oleg-milantiev/ros2-vedrus/Orange Extension Board/HMC5883L.png

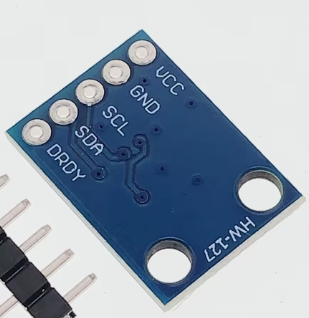
Orange Extension Board/HMC5883L.png
