oleg-milantiev/ros2-vedrus/Orange Extension Board/ads1115.png

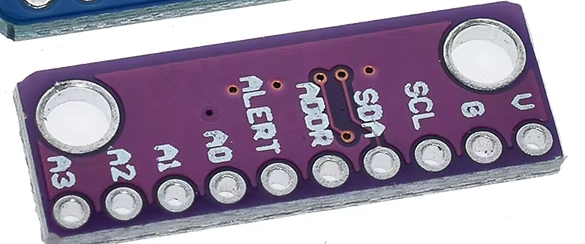
Orange Extension Board/ads1115.png
