oleg-milantiev/ros2-vedrus/README.md

# ros2-vedrus
ROS2 Vedrusohod bot sources
