oleg-milantiev/ros2-vedrus/yolo-world/idea.md

Я создаю DIY робота с элементами исскуственного интеллекта.
Предо мною стоит задача создания датасета с четырёх камер бота.
Я хочу поездить по участку и попросить YOLO-world детектировать для меня ёлку, дом, сарай и другие ориентиры, видимые роботом с разных сторон.
Я буду использовать ограниченный, чётко формализованный список классов, применимый именно для моего участка и объектов на нём.
После составления датасета и его ручной проверки я планирую дотренировать YOLOv8 для быстрого поиска объектов во всех четырёх камерах.

Подскажи, пожулуйста, есть ли смысл в подобной оптимизации?
На сколько подобная дообученная YOLOv8 модель быстрей и лучше справится с широкой YOLO-world при запуске на amd64 и nvidia 3060?

Ваш подход к созданию робота с элементами искусственного интеллекта выглядит продуманным и логичным. Использование YOLO-World для первоначальной разметки данных с последующей дообучкой YOLOv8 — это интересная стратегия, которая сочетает преимущества гибкости и скорости. Давайте разберёмся, имеет ли это смысл и как это может повлиять на производительность на вашем оборудовании (AMD64 CPU и NVIDIA RTX 3060 GPU).

### Имеет ли смысл ваш подход?

Да, ваша стратегия имеет смысл по следующим причинам:

1. **YOLO-World для начальной разметки**:
   - YOLO-World — это модель с открытым словарем (open-vocabulary), которая позволяет детектировать произвольные объекты, описанные текстовыми запросами (например, "ёлка", "дом", "сарай"). Это удобно для автоматизации создания датасета, особенно если вы хотите минимизировать ручную разметку.
   - Она не требует предварительного обучения на ваших классах, что экономит время на старте проекта.
   - Однако YOLO-World оптимизирована для универсальности, а не для скорости или специфичности к ограниченному набору классов, что может снижать её эффективность в вашем случае после разметки.

2. **Дообучка YOLOv8**:
   - После создания и проверки датасета дообученная YOLOv8 будет настроена именно на ваши классы ("ёлка", "дом", "сарай" и т.д.), что улучшит точность и скорость детекции для конкретного сценария.
   - YOLOv8 изначально проектировалась как компактная и быстрая модель для задач реального времени, особенно при использовании GPU (например, NVIDIA 3060). Дообучка на вашем датасете сделает её ещё более эффективной для ваших нужд.
   - Вы сможете выбрать подходящий размер модели (например, YOLOv8n для скорости или YOLOv8m для баланса скорости и точности), что даёт гибкость в оптимизации под оборудование.

3. **Оптимизация под задачу**:
   - Ваш случай предполагает ограниченный и чётко определённый список классов. Это идеальный сценарий для дообученной модели, так как она будет лишена "избыточной универсальности" YOLO-World, которая не нужна для фиксированного набора объектов.
   - Дообученная YOLOv8 сможет лучше обобщать данные с ваших камер, учитывая особенности освещения, углов обзора и текстур на вашем участке.

Таким образом, ваш подход позволяет использовать сильные стороны обеих моделей: YOLO-World для быстрого прототипирования и разметки, а YOLOv8 для финальной оптимизированной работы в реальном времени.

---

### Сравнение производительности: дообученная YOLOv8 vs YOLO-World

Чтобы оценить, насколько дообученная YOLOv8 будет быстрее и лучше YOLO-World на вашем оборудовании (AMD64 CPU и NVIDIA RTX 3060), рассмотрим ключевые аспекты:

#### 1. Скорость (FPS — кадры в секунду)
- **YOLO-World**:
  - YOLO-World построена на основе YOLOv8, но включает дополнительные компоненты (например, интеграцию с CLIP для обработки текстовых запросов), что увеличивает вычислительную нагрузку.
  - На NVIDIA RTX 3060 (12 ГБ VRAM, ~5000 CUDA-ядер) YOLO-World (например, версия на базе YOLOv8s) может выдавать около 30-50 FPS при разрешении 640x640 в зависимости от сложности сцены и количества классов в запросе. Однако это значение может снижаться из-за дополнительных вычислений для open-vocabulary возможностей.
  - На CPU (AMD64) её производительность резко падает (до 1-5 FPS), так как модель не оптимизирована для процессоров без CUDA.

- **Дообученная YOLOv8**:
  - YOLOv8 (например, YOLOv8n или YOLOv8s) изначально быстрее благодаря упрощённой архитектуре, заточенной под фиксированные классы.
  - На RTX 3060 YOLOv8n может достигать 100-150 FPS, а YOLOv8s — около 70-100 FPS при разрешении 640x640 с использованием CUDA и оптимизаций (например, TensorRT).
  - На CPU (AMD64) YOLOv8n выдаёт примерно 10-20 FPS, что всё равно значительно лучше, чем YOLO-World, благодаря меньшему количеству параметров и отсутствию лишних вычислений.

- **Вывод**: Дообученная YOLOv8 будет **в 2-3 раза быстрее** YOLO-World на GPU и заметно быстрее на CPU, особенно если вы выберете компактную версию (например, YOLOv8n).

#### 2. Точность (mAP — mean Average Precision)
- **YOLO-World**:
  - Точность YOLO-World зависит от качества текстовых описаний и предварительного обучения на больших наборах данных (например, COCO, Open Images). Для ваших специфичных объектов ("ёлка с моего участка", "сарай с определённым углом") она может быть ниже из-за недостатка контекста в общем предобучении.
  - mAP может составлять 0.3-0.5 для новых объектов в zero-shot режиме, что приемлемо для разметки, но не идеально для точной работы робота.

- **Дообученная YOLOv8**:
  - После дообучки на вашем датасете YOLOv8 будет учитывать особенности ваших объектов и камер, что поднимет mAP до 0.7-0.9 (в зависимости от качества датасета и объёма данных).
  - Специализация на ограниченном наборе классов устраняет "шум" от лишних объектов, что повышает точность детекции.

- **Вывод**: Дообученная YOLOv8 обеспечит **значительно более высокую точность** (на 20-50% выше по mAP) для ваших задач по сравнению с YOLO-World.

#### 3. Ресурсоёмкость
- **YOLO-World**:
  - Имеет больше параметров из-за интеграции CLIP и сложной обработки текстовых запросов. Это увеличивает потребление памяти (VRAM) и вычислительных ресурсов.
  - На RTX 3060 может занимать 4-6 ГБ VRAM, что ограничивает параллельную обработку с четырёх камер без оптимизации.

- **Дообученная YOLOv8**:
  - YOLOv8n (nano) занимает около 1-2 ГБ VRAM, а YOLOv8s — около 3-4 ГБ, что делает её более подходящей для одновременной работы с несколькими потоками (4 камеры).
  - Меньшее количество параметров снижает нагрузку на CPU/GPU, что важно для DIY-робота с ограниченными ресурсами.

- **Вывод**: Дообученная YOLOv8 **менее ресурсоёмка** и лучше подходит для многоканальной обработки.

#### 4. Реальное время на вашем оборудовании
- Для робота с четырьмя камерами критично обрабатывать видео в реальном времени (хотя бы 15-30 FPS на поток).
- YOLO-World на RTX 3060 может не справиться с четырьмя потоками одновременно на приемлемой скорости без серьёзной оптимизации (например, уменьшения разрешения или batch processing).
- YOLOv8 (дообученная) на RTX 3060 с TensorRT или ONNX-оптимизацией легко обеспечит 30+ FPS на поток при разрешении 640x640, что идеально для вашей задачи.

---

### Итоговые рекомендации
1. **Смысл есть**: Ваш подход с использованием YOLO-World для разметки и дообучки YOLOv8 для финальной модели — это разумная комбинация гибкости и производительности.
2. **Преимущества дообученной YOLOv8**:
   - **Скорость**: в 2-3 раза выше (70-150 FPS vs 30-50 FPS на GPU).
   - **Точность**: mAP выше на 20-50% для ваших классов.
   - **Эффективность**: меньшая нагрузка на ресурсы, что критично для работы с 4 камерами.
3. **Выбор версии YOLOv8**:
   - Для максимальной скорости используйте **YOLOv8n** (nano).
   - Для баланса скорости и точности — **YOLOv8s** (small).
   - Настройте размер входного изображения (например, 320x320 вместо 640x640), если нужна ещё большая скорость.
4. **Оптимизация на NVIDIA 3060**:
   - Используйте **TensorRT** для ускорения инференса (может увеличить FPS на 30-50%).
   - Настройте параллельную обработку потоков с камер (например, с помощью multiprocessing или CUDA Streams).

Ваш план оптимизации не только оправдан, но и позволит создать быстрого и точного робота, идеально подходящего для вашего участка. Удачи в проекте! Если будут вопросы по реализации, обращайтесь.
