oleg-milantiev/ros2-vedrus/Orange Extension Board/HC-SR04.jpg

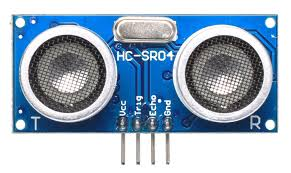
Orange Extension Board/HC-SR04.jpg
