oleg-milantiev/ros2-vedrus/rosgraph.png

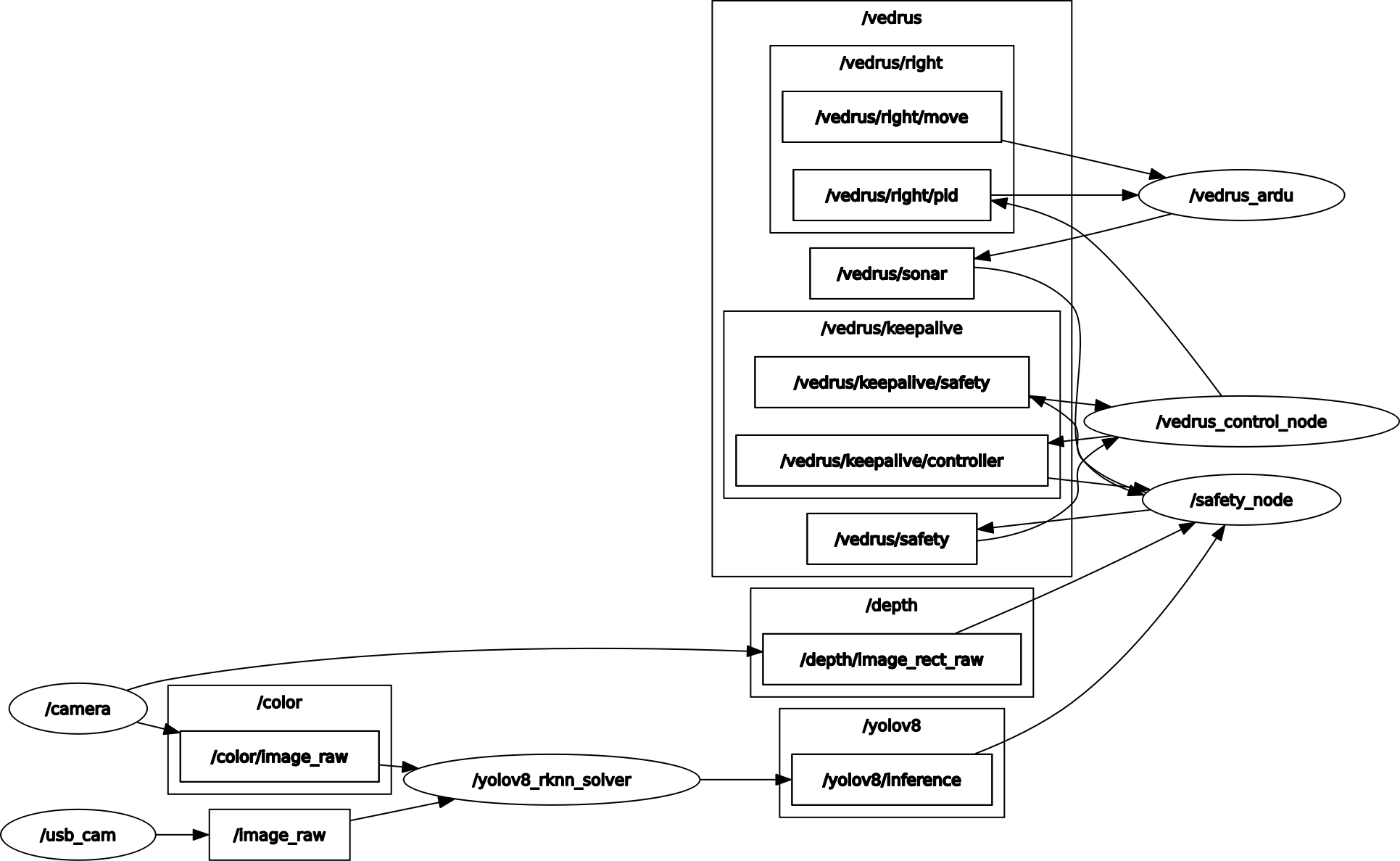
rosgraph.png
