oleg-milantiev/ros2-vedrus/(list of files, cad)

Other CAD files:
Cameras Board.3dm
