oleg-milantiev/ros2-vedrus/Orange Extension Board/Orange Extension Board/Orange Extension Board.kicad_pcb

## KiCad design Orange Extension Board/Orange Extension Board/Orange Extension Board.kicad_pcb (2025-02-04)

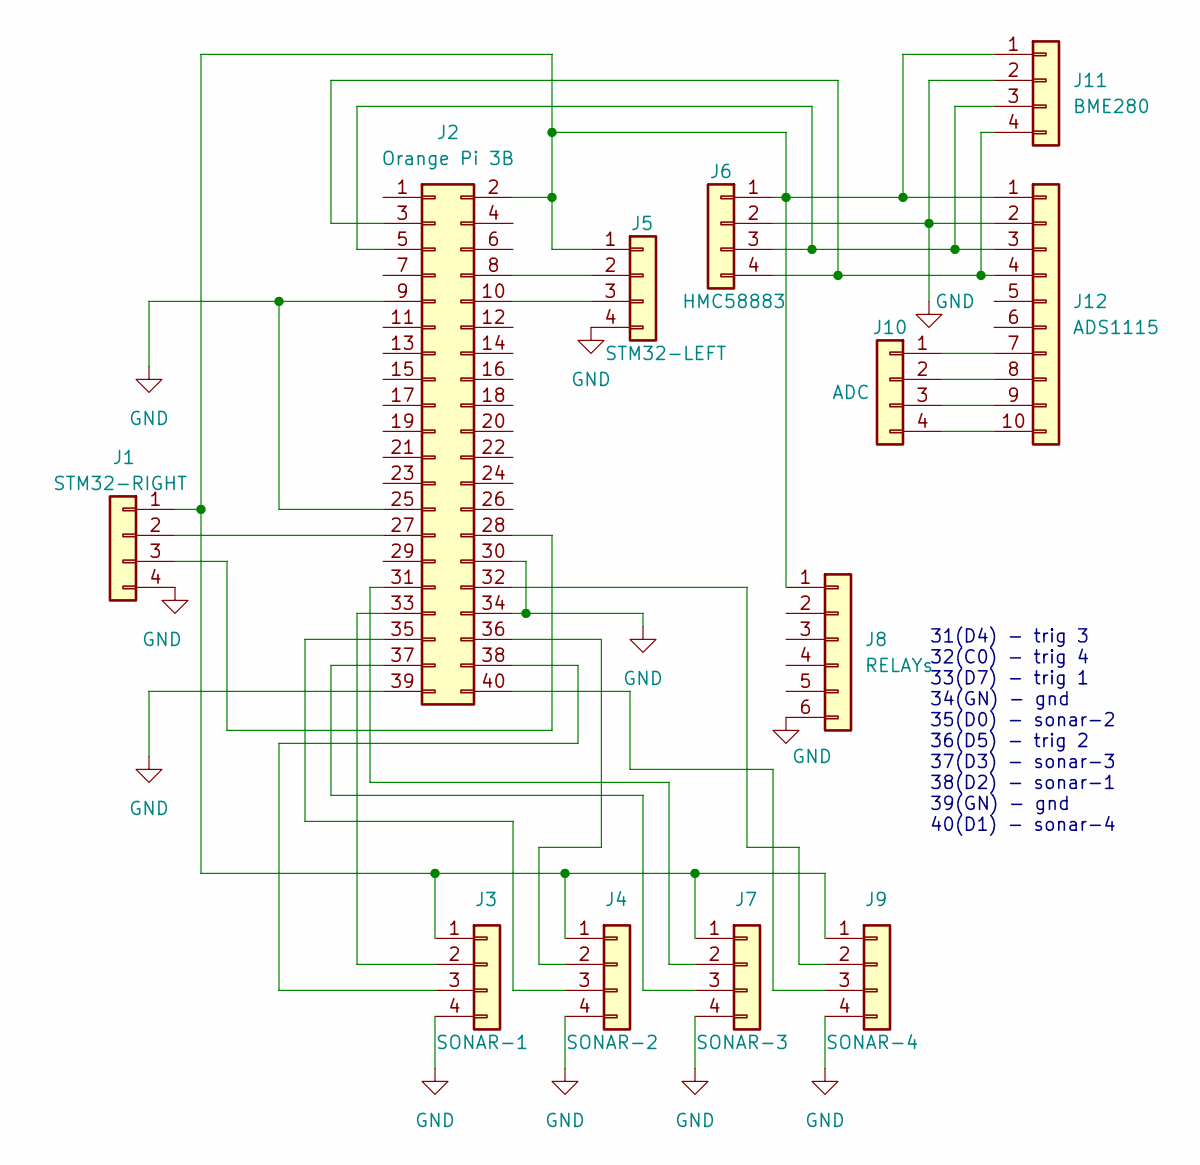
[picture p5: schematic Orange Extension Board.kicad_sch]

Parts:
J1: STM32-RIGHT; PinHeader_1x04_P2.54mm_Vertical
J2: Orange Pi 3B; PinHeader_2x20_P2.54mm_Vertical
J3: SONAR-1; PinHeader_1x04_P2.54mm_Vertical
J4: SONAR-2; PinHeader_1x04_P2.54mm_Vertical
J5: STM32-LEFT; PinHeader_1x04_P2.54mm_Vertical
J6: HMC58883; PinHeader_1x04_P2.54mm_Vertical
J7: SONAR-3; PinHeader_1x04_P2.54mm_Vertical
J8: RELAYs; PinHeader_1x06_P2.54mm_Vertical
J9: SONAR-4; PinHeader_1x04_P2.54mm_Vertical
J10: ADC; PinHeader_1x04_P2.54mm_Vertical
J11: BME280; PinHeader_1x04_P2.54mm_Vertical
J12: ADS1115; PinHeader_1x10_P2.54mm_Vertical

Connections:
GND: J1.4, J2.9, J2.25, J2.30, J2.34, J2.39, J3.4, J4.4, J5.4, J6.2, J7.4, J8.6, J9.4, J11.2, J12.2
unnamed: J1.1, J2.2, J3.1, J4.1, J5.1, J6.1, J7.1, J8.1, J9.1, J11.1, J12.1
unnamed: J1.2, J2.27
unnamed: J1.3, J2.28
unnamed: J2.3, J6.4, J11.4, J12.4
unnamed: J2.5, J6.3, J11.3, J12.3
unnamed: J2.8, J5.2
unnamed: J2.10, J5.3
unnamed: J2.32, J9.2
unnamed: J2.33, J3.2
unnamed: J2.40, J9.3
unnamed: J2.38, J3.3
unnamed: J2.36, J4.2
unnamed: J2.35, J4.3
unnamed: J2.31, J7.2
unnamed: J2.37, J7.3
unnamed: J10.1, J12.7
unnamed: J10.2, J12.8
unnamed: J10.3, J12.9
unnamed: J10.4, J12.10

Notes on the sheet:
31(D4) - trig 3 32(C0) - trig 4 33(D7) - trig 1 34(GN) - gnd 35(D0) - sonar-2 36(D5) - trig 2 37(D3) - sonar-3 38(D2) - sonar-1 39(GN) - gnd 40(D1) - sonar-4

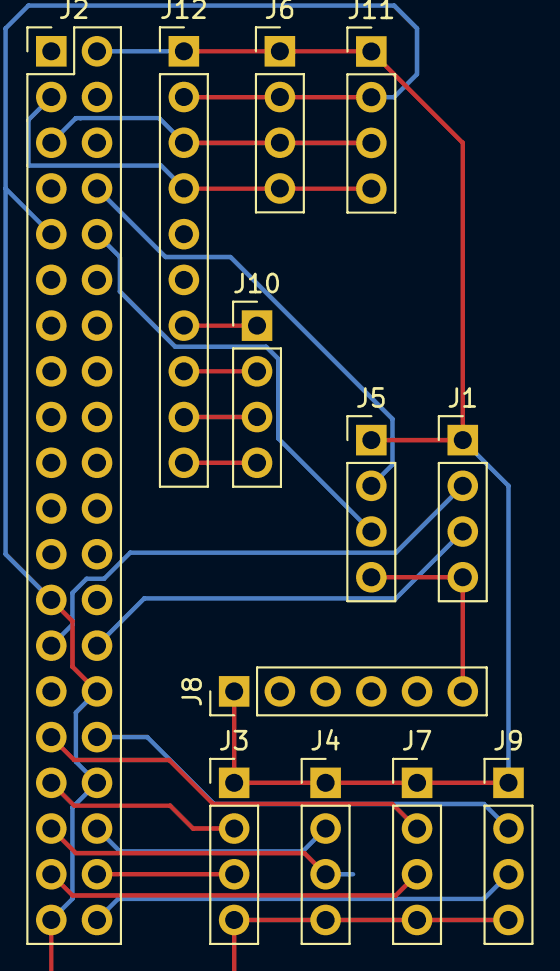
[picture p6: board Orange Extension Board.kicad_pcb from above]

Board: 2 copper layers, 12 parts (0 on the bottom side), 20 nets.
