oleg-milantiev/ros2-vedrus/BluePill/KiCAD/BluePill/BluePill.kicad_pcb

## KiCad design BluePill/KiCAD/BluePill/BluePill.kicad_pcb (2024-12-22)

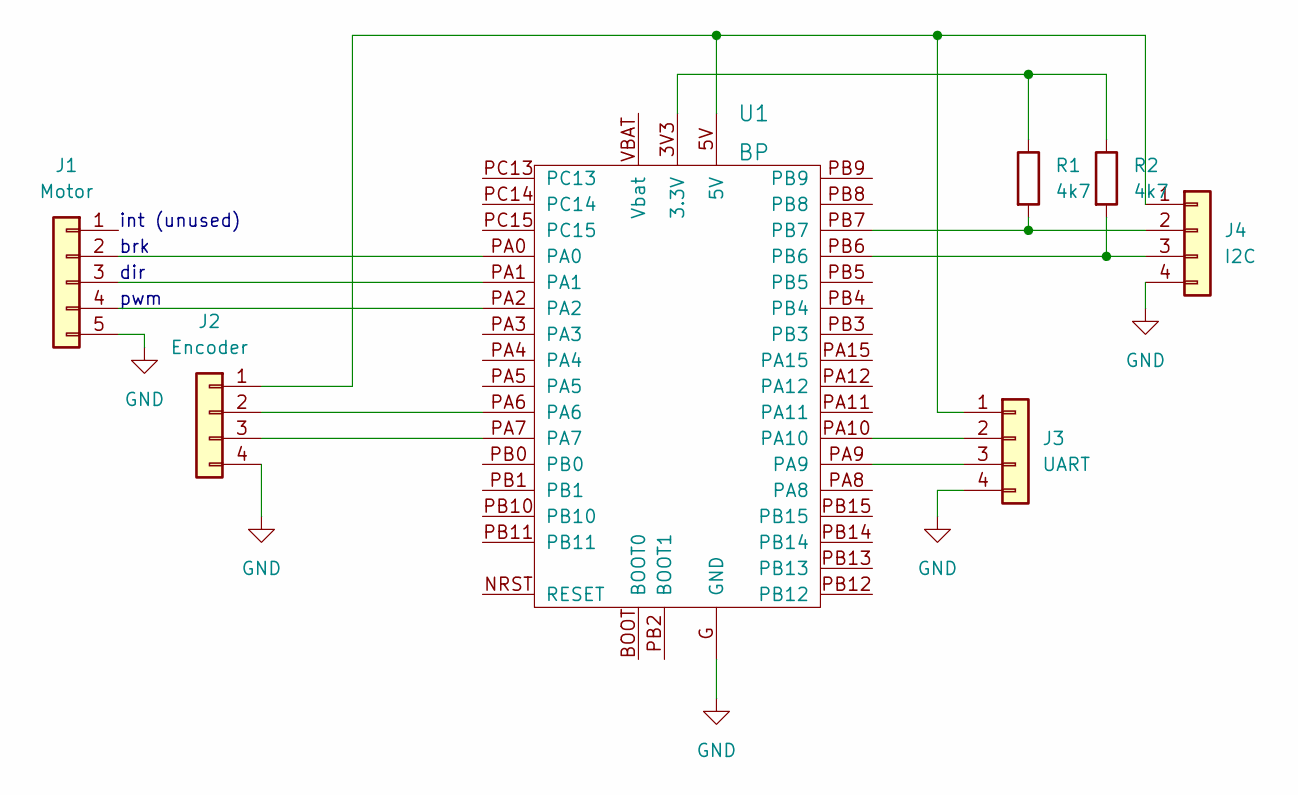
[picture p7: schematic BluePill.kicad_sch]

Parts:
J1: Motor; PinHeader_1x05_P2.54mm_Vertical
J2: Encoder; PinHeader_1x04_P2.54mm_Vertical
J3: UART; PinHeader_1x04_P2.54mm_Vertical
J4: I2C; PinHeader_1x04_P2.54mm_Vertical
R1, R2: 4k7; R_Axial_DIN0204_L3.6mm_D1.6mm_P2.54mm_Vertical
U1: BP; blue_pill

Connections:
GND: J1.5, J2.4, J3.4, J4.4, U1.G (GND)
unnamed: J1.2, U1.PA0
unnamed: J1.3, U1.PA1
unnamed: J1.4, U1.PA2
unnamed: J2.1, J3.1, J4.1, U1.5V
unnamed: J2.2, U1.PA6
unnamed: J2.3, U1.PA7
unnamed: J3.2, U1.PA10
unnamed: J3.3, U1.PA9
unnamed: J4.2, R1.2, U1.PB7
unnamed: J4.3, R2.2, U1.PB6
unnamed: R1.1, R2.1, U1.3V3 (3.3V)

Notes on the sheet:
int (unused)
pwm
dir
brk

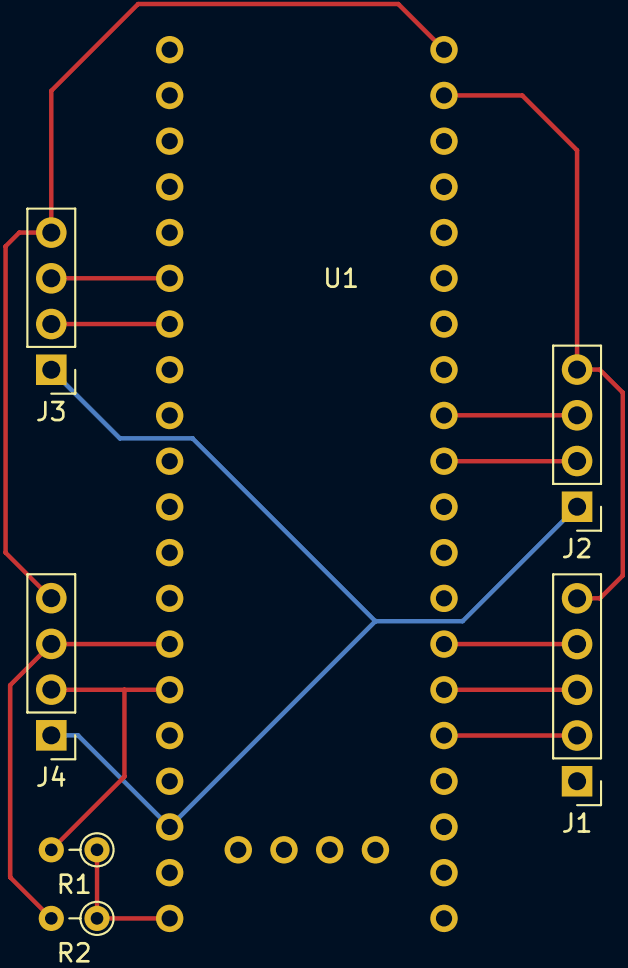
[picture p8: board BluePill.kicad_pcb from above]

Board: 2 copper layers, 7 parts (0 on the bottom side), 12 nets.
