oleg-milantiev/ros2-vedrus/arduino/motor/kicad/vedro-ardu.kicad_pcb

## KiCad design arduino/motor/kicad/vedro-ardu.kicad_pcb (2024-02-14)

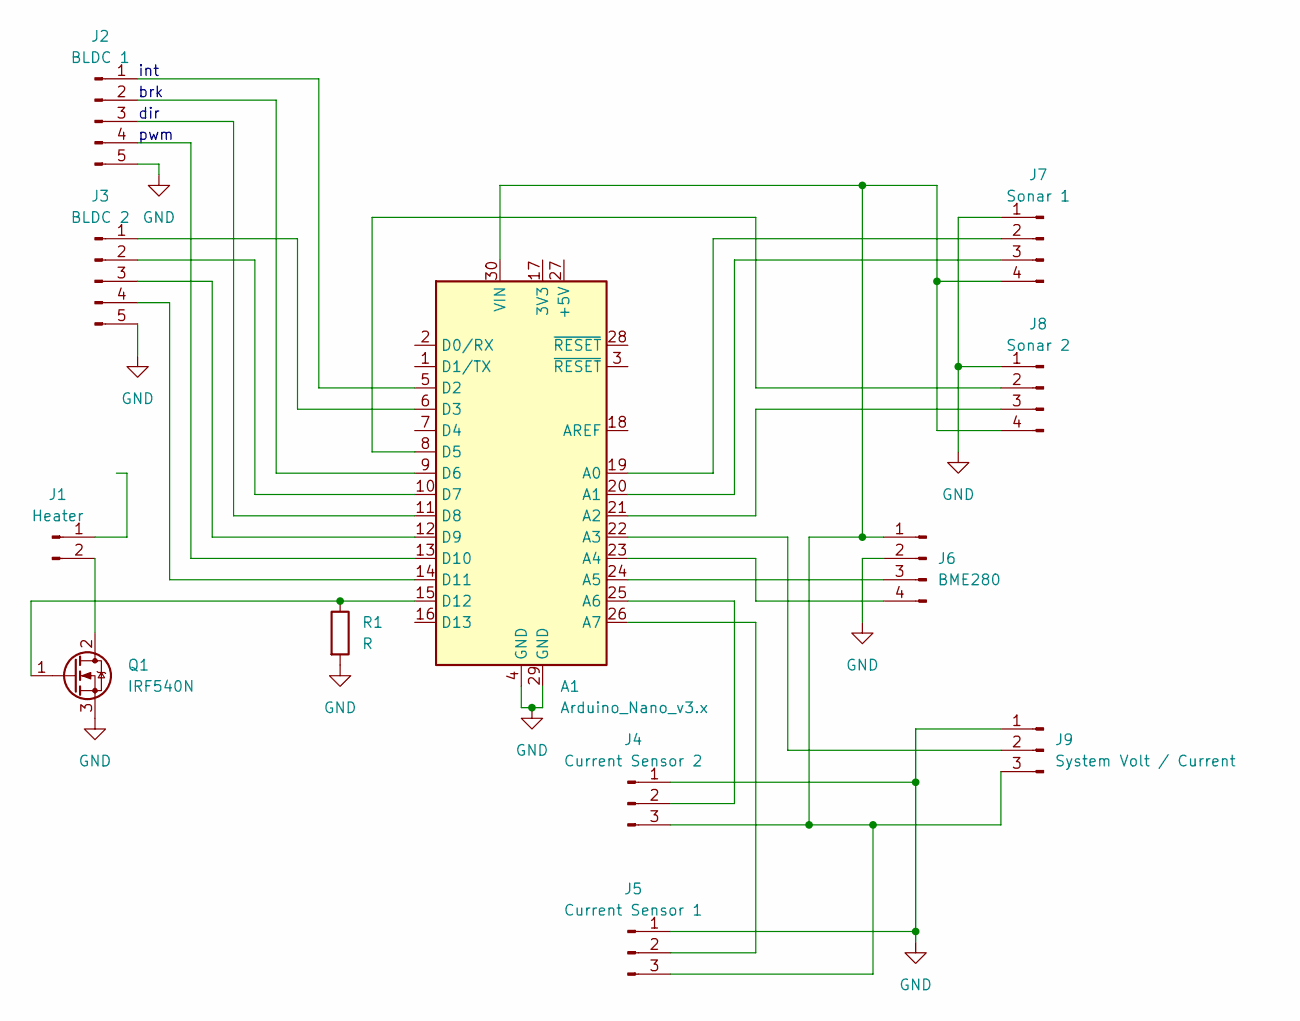
[picture p9: schematic vedro-ardu.kicad_sch]

Parts:
A1: Arduino_Nano_v3.x; Arduino_Nano
J1: Heater; PinHeader_1x02_P2.54mm_Vertical
J2: BLDC 1; PinHeader_1x05_P2.54mm_Vertical
J3: BLDC 2; PinHeader_1x05_P2.54mm_Vertical
J4: Current Sensor 2; PinHeader_1x03_P2.54mm_Vertical
J5: Current Sensor 1; PinHeader_1x03_P2.54mm_Vertical
J6: BME280; PinHeader_1x04_P2.54mm_Vertical
J7: Sonar 1; PinHeader_1x04_P2.54mm_Vertical
J8: Sonar 2; PinHeader_1x04_P2.54mm_Vertical
J9: System Volt / Current; PinHeader_1x03_P2.54mm_Vertical
Q1: IRF540N; TO-220-3_Vertical
R1: R; R_0805_2012Metric

Connections:
GND: A1.4 (GND), A1.29 (GND), J2.5, J3.5, J4.1, J5.1, J6.2, J7.1, J8.1, J9.1, Q1.3 (S), R1.2
unnamed: A1.5 (D2), J2.1
unnamed: A1.6 (D3), J3.1
unnamed: A1.8 (D5), J8.2
unnamed: A1.9 (D6), J2.2
unnamed: A1.10 (D7), J3.2
unnamed: A1.11 (D8), J2.3
unnamed: A1.12 (D9), J3.3
unnamed: A1.13 (D10), J2.4
unnamed: A1.14 (D11), J3.4
unnamed: A1.15 (D12), Q1.1 (G), R1.1
unnamed: A1.19 (A0), J7.2
unnamed: A1.21 (A2), J8.3
unnamed: A1.22 (A3), J9.2
unnamed: A1.23 (A4), J6.4
unnamed: A1.24 (A5), J6.3
unnamed: A1.25 (A6), J4.2
unnamed: A1.26 (A7), J5.2
unnamed: A1.30 (VIN), J4.3, J5.3, J6.1, J7.4, J8.4, J9.3
unnamed: J1.2, Q1.2 (D)
unnamed: A1.20 (A1), J7.3

Notes on the sheet:
pwm
dir
brk
int

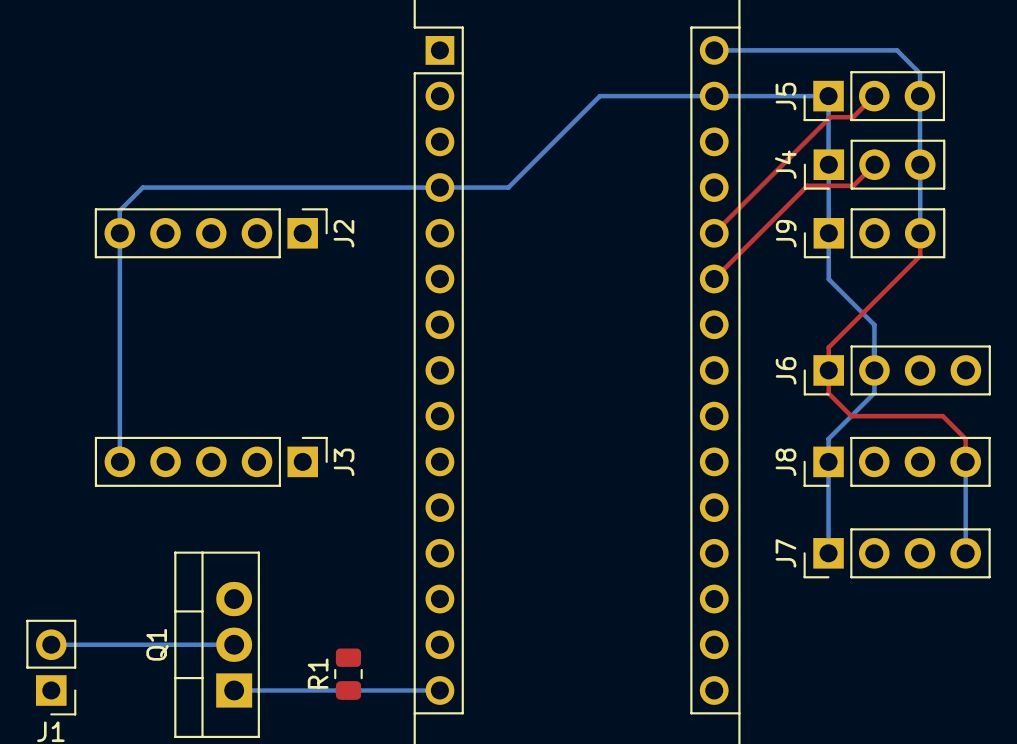
[picture p10: board vedro-ardu.kicad_pcb from above]

Board: 2 copper layers, 12 parts (0 on the bottom side), 21 nets.
