oleg-milantiev/ros2-vedrus/vedrus/vedrus/server.py

import asyncio
from aiohttp import web
import os
import rclpy
from rclpy.node import Node
import threading
from vedrus_interfaces.msg import Safety, KeepAlive, MotorMove, MotorPID, Status

# TDB ад! :)
import sys
sys.path.insert(0, '/opt/ros/iron/build/vedrus/vedrus')
from rclpy_param_helper import call_get_parameters, call_set_parameters


'''
TODO
- move to websockets
'''

class ServerNode(Node):
	def web_homepage(self, request):
		with open('/opt/ros/iron/src/vedrus/html/index.html', 'r') as file:
			return web.Response(text=file.read(), content_type='text/html')

	async def web_status(self, request):
		data = {
			'ardu': self.ardu,
			'controller': self.controller,
			'safety': self.safety,
			'motor': {
				'left': {
					'move': self.motorMoveLeft,
					'pid': self.motorPidLeft,
				},
				'right': {
					'move': self.motorMoveRight,
					'pid': self.motorPidRight,
				},
			},
		}
		return web.json_response(data)

	async def web_control(self, request):
		data = await request.json()

		try:
			dataFloat = {
				'p': float(data['ardu_p']),
				'i': float(data['ardu_i']),
				'd': float(data['ardu_d']),
			}
		except ValueError as ex:
			print(ex)
			return

		call_set_parameters(self, '/vedrus_ardu', dataFloat)

		# Handle the POST request data
		return web.Response(text='OK')

	def aiohttp_server(self):
		app = web.Application()
		app.add_routes([web.get('/', self.web_homepage)])
		app.router.add_get('/status', self.web_status)
		app.router.add_post('/control', self.web_control)

		runner = web.AppRunner(app)
		return runner

	def run_server(self, runner):
		self.loop = asyncio.new_event_loop()
		asyncio.set_event_loop(self.loop)
		self.loop.run_until_complete(runner.setup())
		site = web.TCPSite(runner, '0.0.0.0', 8080)
		self.loop.run_until_complete(site.start())
		self.loop.run_forever()

	def __init__(self):
		super().__init__('vedrus_server_node')

		self.ardu = call_get_parameters(self, '/vedrus_ardu', ['p', 'i', 'd'])
		print(self.ardu)

		self.web_thread = threading.Thread(target=self.run_server, args=(self.aiohttp_server(),))
		self.web_thread.start()

		self.create_subscription(Safety, '/vedrus/safety', self.safety_callback, 10)

		self.create_subscription(Status, '/vedrus/status', self.status_callback, 10)

		self.create_subscription(MotorMove, '/vedrus/left/move', self.motorMove_left_callback, 10)
		self.create_subscription(MotorMove, '/vedrus/right/move', self.motorMove_right_callback, 10)

		self.create_subscription(MotorPID, '/vedrus/left/pid', self.motorPID_left_callback, 10)
		self.create_subscription(MotorPID, '/vedrus/right/pid', self.motorPID_right_callback, 10)

	safety = []
	ardu = None
	motorPidLeft = None
	motorPidRight = None
	motorMoveLeft = None
	motorMoveRight = None
	controller = None

	def status_callback(self, msg):
		self.controller = {item.name: item.value for item in msg.items}

	def motorPID_left_callback(self, msg):
		self.motorPidLeft = {
			'breaking': msg.breaking,
			'speed': msg.speed,
		}

	def motorPID_right_callback(self, msg):
		self.motorPidRight = {
			'breaking': msg.breaking,
			'speed': msg.speed,
		}

	def motorMove_left_callback(self, msg):
		self.motorMoveLeft = {
			'crash': msg.crash,
			'breaking': msg.breaking,
			'forward': msg.forward,
			'power1': msg.power1,
			'power2': msg.power2,
		}

	def motorMove_right_callback(self, msg):
		self.motorMoveRight = {
			'crash': msg.crash,
			'breaking': msg.breaking,
			'forward': msg.forward,
			'power1': msg.power1,
			'power2': msg.power2,
		}

	def safety_callback(self, msg):
		time = msg.header.stamp.sec + msg.header.stamp.nanosec / 1e9

		self.safety.append({
			'time': time,
			'id': msg.header.frame_id,
			'azimuth': msg.azimuth,
			'range': msg.range,
		})

		self.safety = [item for item in self.safety if item['time'] >= (time - 1)]

def main(args=None):
	rclpy.init(args=args)
	server_node = ServerNode()

	server_node.get_logger().info('Starting...')

	try:
		rclpy.spin(server_node)
	except KeyboardInterrupt:
		pass

	server_node.loop.stop()
	server_node.get_logger().info('Shutting down...')
	rclpy.shutdown()

if __name__ == '__main__':
	main()
