oleg-milantiev/ros2-vedrus/BluePill/serial_control.py

#!/usr/bin/env python3

''' 
This script controls the BluePill microcontroller via a serial interface.
It allows for real-time command input to adjust PID parameters and control speed.

Key Commands:
S = Stop the motor
0-9 = Set speed (0-4500 RPM, where each digit corresponds to 500 RPM)
P/p = Increase/Decrease Kp (Proportional gain)
I/i = Increase/Decrease Ki (Integral gain)
D/d = Increase/Decrease Kd (Derivative gain)
Q = Quit the program
'''

import serial
import os
import sys
import termios
import tty
import threading

# Configuration
SERIAL_PORT = '/dev/ttyUSB0'
SERIAL_PORT = '/dev/ttyS2' # 2 - left, 3 - right
BAUD_RATE = 115200

# Add PID parameter tracking
pid_values = {'P': 0.0, 'I': 0.0, 'D': 0.0}

def get_key():
    """Get a single keypress from stdin without waiting for enter"""
    fd = sys.stdin.fileno()
    old_settings = termios.tcgetattr(fd)
    try:
        tty.setraw(sys.stdin.fileno())
        ch = sys.stdin.read(1)
    finally:
        termios.tcsetattr(fd, termios.TCSADRAIN, old_settings)
    return ch

def read_serial(ser):
    """Read and print serial data in a separate thread"""
    while True:
        if ser.in_waiting:
            try:
                line = ser.readline().decode('utf-8').strip()
                # Parse PID values from VEDL/VEDR format
                if line.startswith(('VEDL', 'VEDR')):
                    # Split the line into sections
                    sections = line.split(',')
                    for section in sections:
                        if section.startswith('PID:'):
                            # Extract PID values (format: PID:P/I/D)
                            pid_str = section.split(':')[1]
                            p, i, d = map(float, pid_str.split('/'))
                            pid_values['P'] = p
                            pid_values['I'] = i
                            pid_values['D'] = d
                print(f"\r{line.ljust(79)}", end="\r")
            except UnicodeDecodeError:
                pass
            except serial.SerialException:
                print("\nSerial connection lost!")
                break

def printClear(text):
    print("\r", text.ljust(80))

def main():
    try:
        os.system('clear')

        # Open serial port
        ser = serial.Serial(SERIAL_PORT, BAUD_RATE, timeout=1)
        print(f"Connected to {SERIAL_PORT}")

        # Start reading thread
        read_thread = threading.Thread(target=read_serial, args=(ser,), daemon=True)
        read_thread.start()

        print("Commands:")
        print("S=Stop, 0-9=Speed")
        print("P/p=Inc/Dec Kp, I/i=Inc/Dec Ki, D/d=Inc/Dec Kd")
        print("Q=Quit")
        print("\nEnter command: ", end='', flush=True)

        while True:
            key = get_key()

            if key.lower() == 'q':
                break
            elif key.lower() == 's':
                ser.write(b'S\n')
                printClear("\rSending: STOP")
            elif key.isdigit():
                speed = int(key) * 500
                command = f'M{speed}\n'.encode()
                ser.write(command)
                printClear(f"\rSending: MOVE {speed}")
            elif key in ['P', 'p', 'I', 'i', 'D', 'd']:
                param = key.upper()
                increment = 0.001 if key.isupper() else -0.001
                if (pid_values[param] + increment) >= 0:
                    pid_values[param] += increment
                    ser.write(f'{param}{pid_values[param]:.3f}\n'.encode())
                    printClear(f"\rSending: Adjust {param} by {increment} (Current value: {pid_values[param]:.3f})")
                else:
                    printClear(f"\rCannot decrease {param} below 0.0 (Current value: {pid_values[param]:.3f})")

    except serial.SerialException as e:
        print(f"Error opening serial port: {e}")
    except KeyboardInterrupt:
        print("\nExiting...")
    finally:
        if 'ser' in locals():
            ser.close()
            print("Serial port closed")

if __name__ == "__main__":
    main() 
