oleg-milantiev/ros2-vedrus/(commit log)

2024-02-13 Gyro RC
2024-02-14 Arduino devices
    [vedro-ardu.kicad_pcb, vedro-ardu.kicad_sch]
2024-02-26 YOLOv8 RKNN Solver - multiple cameras, frame rate, move allmost into parameters
2024-02-27 YOLOv8-RKNN - Multiple cameras
2024-02-28 Ardu - add power and dir into output
2024-03-01 Safety node - working RGBD and Sonar
2024-03-02 USB Camera search
2024-03-07 Separate side motors controlling
2024-03-09 SpeedUp arduino firmware by less average ADC and sonar. Limit sonar to 150 cm
2024-03-09 Add simple-pid into installer
2024-03-09 Async Serial. Motors PID regulators. Low cost CSV logger.
2024-03-13 Return to 16 count adc mean. No any improve :(
2024-03-13 Add Controller with task_safety_forward in. Add KeepAlive into Safety and Controller. Add Crash flag into Ardu motor control. Add Breaking flag into Ardu PID motor control.
    [controller.py, gyro.controller.py, safety.py, screen.py]
2024-03-13 Add moving polarity to PID. Add new task_safety_rotate_to_person
2024-03-25 Ardu: PID now send motor command via ROS (to use info in server / remote controll)
2024-03-25 Greately improved remote (controller status, motors power and pid, graphics improvements)
2024-12-15 Start to move from atmega8 to stm32 (blue pill)
2024-12-22 Debugging BluePill
    [BluePill.kicad_pcb, BluePill.kicad_sch]
2024-12-22 Comment unused, but maybe useful in future median filtering
2024-12-26 Arduino 2 and I2C tests
2025-01-16 Sensors publishers
2025-01-16 Voltage interface
2025-01-17 Sensors: Working in launch
2025-01-17 Motor interfaces
2025-02-01 Add sonar names
2025-02-04 Remove I2C
2025-02-04 Extension board init
    [Orange Extension Board.kicad_pcb, Orange Extension Board.kicad_sch]
2025-02-07 3 USB cameras in they places
2025-02-17 Add old-good crash signal to stop motors forever
    [bluepill.py]
2025-02-24 Reverse motor status
2025-02-24 Remove depth camera noise
    [safety.py]
2025-02-25 Add sonar and realsense keepalives
2025-02-25 Fix: next move must be 20k
    [controller.py]
2025-02-25 Add four keepalives for motors, bearing and safety
2025-02-25 Add azimuths to sonar. Move to vedrus.Sonar
2025-02-26 Move to meters in Sonar messages
2025-02-26 Correct pins. Short sonars test launch
    [sonar.py]
2025-02-26 Correct pins. Up rate by 10 times! Median filter at 10 items window. Use edges detector decrease CPU load.
    [sonar.py]
2025-02-26 Improve logging. Tune constants. ModeSafetyStop start from stopping motors
2025-03-04 Try to tune camera brightness
2025-03-05 Try to prevent controller hangup
    [BluePill.ino]
2025-03-05 Shorter max-pwm
2025-03-05 Try to resolve driver hangup
    [BluePill.ino]
2025-03-09 Save camera's images for dataset
2025-03-21 Optimize camera names. Use nvidia
2025-03-22 STM32 Two Motors
2025-03-23 Actual schema (not a board)
    [BluePill.kicad_sch]
